oschwartz10612/Scanner-Pro-MK3/firmware/FCPS_Firmware_2.0/README.md

# Scanner Pro MK3
Takes USB input from a USB Keyboard HID device and sends the message to the computer with customizable macros.

Works with barcode scanners and USB Keyboards.

### Current Build


## Installation of Scanner Pro Manager
Download the latest manager application from [releases.](https://github.com/oschwartz10612/Scanner-Pro-MK3/releases)

## How to make a custom script?
Custom scripts are easily developed using the Arduino IDE. [Download and install the IDE.](https://www.arduino.cc/en/main/software)

Once developed 

## Firmware 2.0
Firmware 2.0 comes  currently has the following scripts

1. Distribution

2. PXI

3. PXI with FCPSON

### Install Precompiled Firmware
1. Plug in the Scanner Pro to a USB port on a computer.

2. Run Scanner Pro Manager.

3. Ensure that the port is correctly selected.

4. Download the latest firmware from [releases.](https://github.com/oschwartz10612/Scanner-Pro-MK3/releases)

5. Click "Select File" and choose a .hex file.

4. Click "Run".

### Execute Command
Interaction with the device is done through serial commands. This is only for the precompiled firmware from [releases.](https://github.com/oschwartz10612/Scanner-Pro-MK3/releases)

1. Plug in the Scanner Pro to a USB port on a computer.

2. Run Scanner Pro Manager

3. Ensure that the port is correctly selected

4. Click "Connect" and ensure that the device connects.

5. Plug a scanner into the Scanner Pro and scan the following barcode to change the device into program mode.
program

6. Wait for the following output
```
Ready to accept commands!
```

7. Type the command in the input next to "Send" and click "Send"

#### Available GET Commands
```
GET school_code
```
Gets the current school code
```
GET script
```
Gets the current active script.
```
GET installed_scripts
```
Gets the current installed script codes.

#### Available SET Commands
```
SET school_code <code>
```
Sets the school code for the PXI script. This appends to the front of a scanned barcode.

```
SET script <script code>
```
Sets the current active script. Use "GET installed_scripts" to see available installed script codes.
