oschwartz10612/Scanner-Pro-MK3/docs/connect1.png

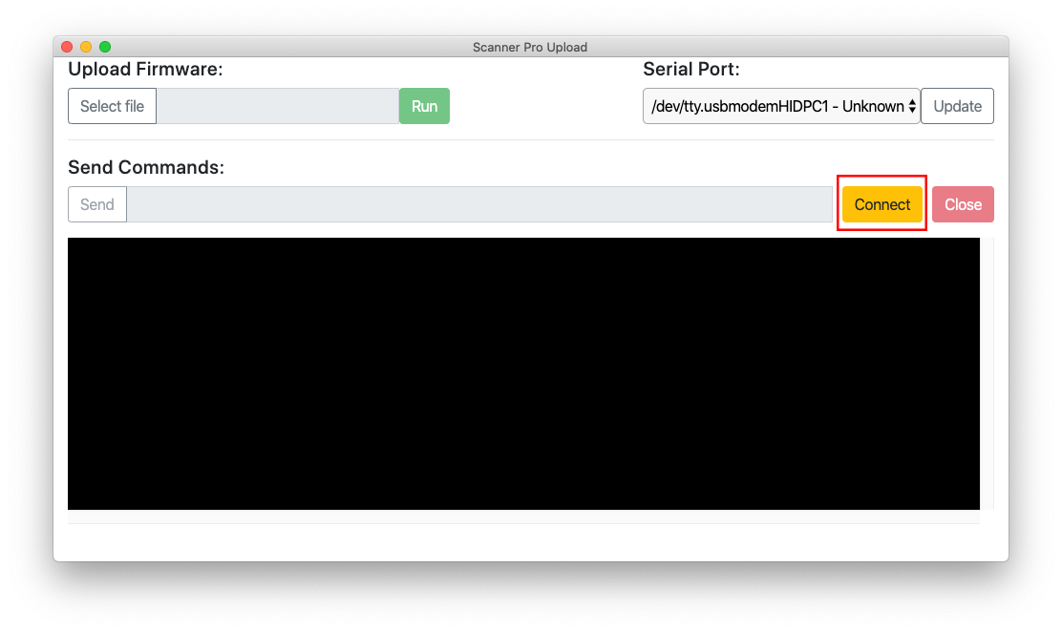
docs/connect1.png
