oschwartz10612/Scanner-Pro-MK3/docs/program.png

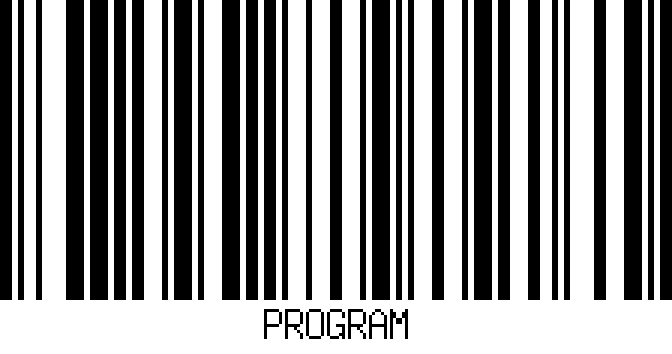
docs/program.png
