oschwartz10612/Scanner-Pro-MK3/PCB/scanner_pro_mk3.brd

## EAGLE design PCB/scanner_pro_mk3.brd (2019-08-08, last stored version)

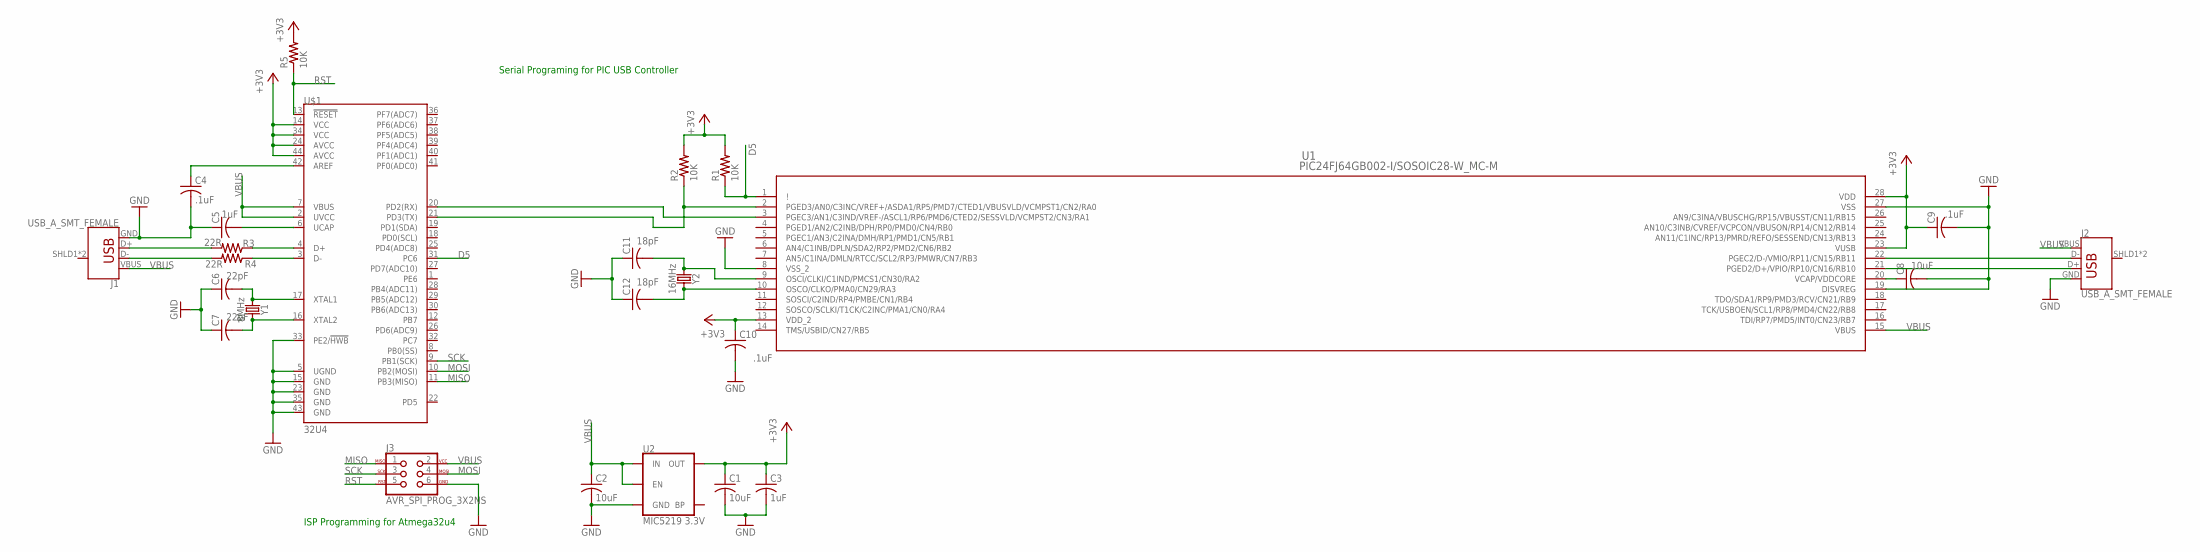
[picture p9: schematic scanner_pro_mk3.sch]

Parts:
C1, C2, C8: 10uF; C0805; MPN CL21B106KPQNFNE
C3, C5: 1uF; C0805; MPN UMK212B7105KG-T
C4, C9, C10: .1uF; C0805; MPN MC0805B104K500CT
C6, C7: 22pF; C0805; MPN MC0805N220J500CT
C11, C12: 18pF; C0805; MPN MC0805N180J500CT
J1, J2: USB_A_SMT_FEMALE; USB-A-S-SILK-FEMALE; MPN UE27-AC54-10H
J3: AVR_SPI_PROG_3X2NS; 2X3-NS
R1, R2, R5: 10K; R0805; MPN CRCW080510K0FKTA
R3, R4: 22R; R0805; MPN CRCW080510K0FKTA
U1: PIC24FJ64GB002-I/SOSOIC28-W_MC-M; SOIC28-W_MC-M; MPN PIC24FJ64GB002-I/SO
U2: MIC5219 3.3V; SOT23-5; MPN MIC5219-3.3YM5-TR
U$1: 32U4; TQFP44; MPN ATMEGA32U4-AU
Y1: 8MHz; CRYSTAL-SMD-5X3.2-4PAD; MPN 7B-8.000MAAJ-T
Y2: 16MHz; CRYSTAL-SMD-5X3.2-4PAD; MPN ABM3B-16.000MHZ-10-1-U-T

Connections:
+3V3: C1.1, C3.1, C9.1, C10.1, R1.2, R2.2, R5.2, U1.13 (VDD_2), U1.23 (VUSB), U1.28 (VDD), U2.5 (OUT), U$1.14 (VCC), U$1.24 (AVCC), U$1.34 (VCC), U$1.44 (AVCC)
D5: R1.1, U1.1 (!), U$1.31 (PC6)
GND: C1.2, C2.2, C3.2, C4.2, C5.1, C6.1, C7.1, C8.2, C9.2, C10.2, C11.1, C12.1, J1.GND, J2.GND, J3.6, U1.8 (VSS_2), U1.19 (DISVREG), U1.27 (VSS), U2.2 (GND), U$1.5 (UGND), U$1.15 (GND), U$1.23 (GND), U$1.33 (PE2/!HWB), U$1.35 (GND), U$1.43 (GND)
MISO: J3.1, U$1.11 (PB3(MISO))
MOSI: J3.4, U$1.10 (PB2(MOSI))
unnamed: J2.D-, U1.22 (PGEC2/D-/VMIO/RP11/CN15/RB11)
unnamed: J2.D+, U1.21 (PGED2/D+/VPIO/RP10/CN16/RB10)
unnamed: U1.3 (PGEC3/AN1/C3IND/VREF-/ASCL1/RP6/PMD6/CT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), U$1.20 (PD2(RX))
unnamed: J1.D+, R3.2
unnamed: J1.D-, R4.2
unnamed: R2.1, U1.2 (PGED3/AN0/C3INC/VREF+/ASDA1/RP5/PMD7/CT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), U$1.21 (PD3(TX))
unnamed: C8.1, U1.20 (VCAP/VDDCORE)
unnamed: C5.2, U$1.6 (UCAP)
unnamed: C4.1, U$1.42 (AREF)
unnamed: C6.2, U$1.17 (XTAL1), Y1.1
unnamed: C7.2, U$1.16 (XTAL2), Y1.3 (2)
unnamed: C12.2, U1.10 (OSCO/CLKO/PMA0/CN29/RA3), Y2.3 (2)
unnamed: C11.2, U1.9 (OSCI/CLKI/C1IND/PMCS1/CN30/RA2), Y2.1
unnamed: R3.1, U$1.4 (D+)
unnamed: R4.1, U$1.3 (D-)
RST: J3.5, R5.1, U$1.13 (!RESET)
SCK: J3.3, U$1.9 (PB1(SCK))
VBUS: C2.1, J1.VBUS, J2.VBUS, J3.2, U1.15 (VBUS), U2.1 (IN), U2.3 (EN), U$1.2 (UVCC), U$1.7 (VBUS)

Notes on the sheet:
ISP Programming for Atmega32u4
Serial Programing for PIC USB Controller

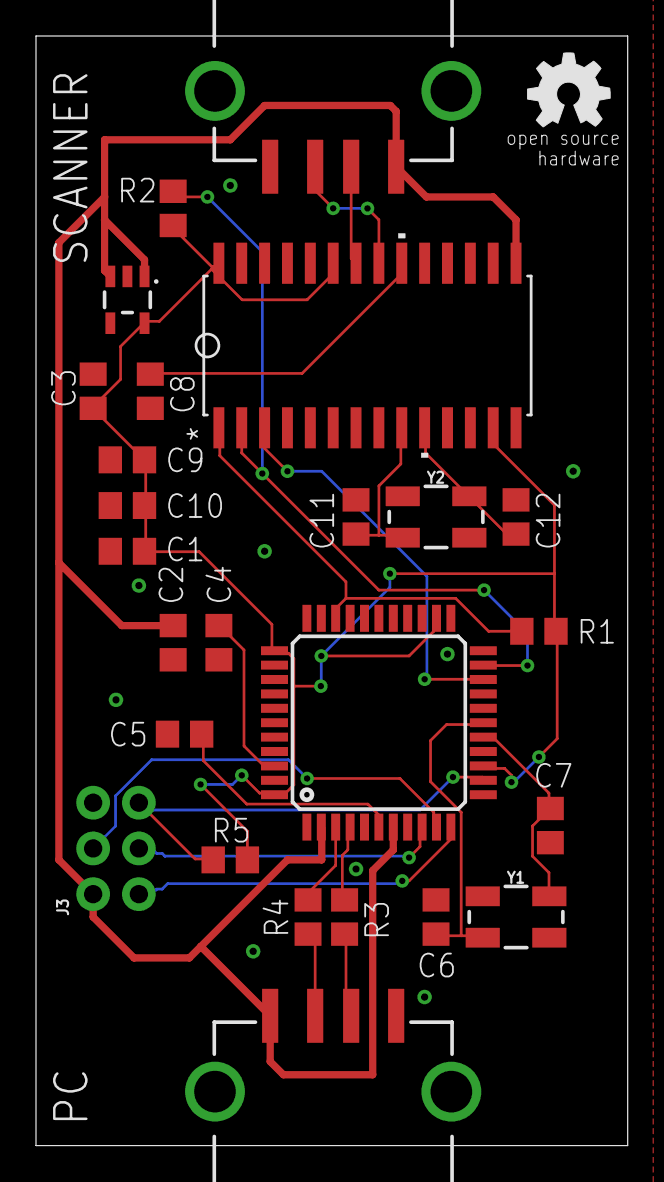
[picture p10: board scanner_pro_mk3.brd from above]

Board: 2 copper layers, 32.9 x 61.6 mm, 26 parts (0 on the bottom side), 23 nets.

Other parts of the board:
U$2: OSHW_5MM
