oschwartz10612/Scanner-Pro-MK3/firmware/FCPS_Firmware_2.0/src/eepromStrings.h

#include <EEPROM.h>

void writeString(char add,String data);
String read_String(char add);

void writeString(char add,String data)
{
  int _size = data.length();
  int i;
  for(i=0;i<_size;i++)
  {
    EEPROM.write(add+i,data[i]);
  }
  EEPROM.write(add+_size,'\0');   //Add termination null character for String Data
}

String read_String(char add)
{
  int i;
  char data[100]; //Max 100 Bytes
  int len=0;
  unsigned char k;
  k=EEPROM.read(add);
  while(k != '\0' && len<500)   //Read until null character
  {    
    k=EEPROM.read(add+len);
    data[len]=k;
    len++;
  }
  data[len]='\0';
  return String(data);
}

template <class T> int EEPROM_writeAnything(int ee, const T& value)
{
    const byte* p = (const byte*)(const void*)&value;
    unsigned int i;
    for (i = 0; i < sizeof(value); i++)
          EEPROM.write(ee++, *p++);
    return i;
}

template <class T> int EEPROM_readAnything(int ee, T& value)
{
    byte* p = (byte*)(void*)&value;
    unsigned int i;
    for (i = 0; i < sizeof(value); i++)
          *p++ = EEPROM.read(ee++);
    return i;
}
