oschwartz10612/Scanner-Pro-MK3/(commit log)

2019-08-06 changed code for hobbytronics board
2019-08-08 added pcb to git
    [scanner_pro_mk3.brd, scanner_pro_mk3.csv, scanner_pro_mk3.sch]
2019-08-19 fixed PXI scripts to add tab
    [main.cpp]
2019-12-05 added LEDs
2019-12-29 checking arduino board json
2019-12-29 editing board json
2019-12-30 made logout button work for auth error
2020-04-21 Compiled new bootloader with USB identification
    Library folder structure changed
    [ConfiguringApps.txt]
2020-04-25 Changed arduino core files
